NTUEE-ESLab/2018Fall-A_CAR/remote/arduino/sensor_1/sensor_1.ino

#include <NewPing.h>

#define SONAR1 13
#define SONAR2 12
#define SONAR3 11
#define SONAR4 10
#define SONAR5 9
#define SONAR6 8

#define SONAR7 7
#define SONAR8 6
#define SONAR9 5

#define MAX_DISTANCE 800 // maximum distance for sensors
#define NUM_SONAR  8// number of sonar sensors 

NewPing sonar[NUM_SONAR] = { // array of sonar sensor objects
  NewPing(SONAR1, SONAR1, MAX_DISTANCE),
  NewPing(SONAR2, SONAR2, MAX_DISTANCE),
  NewPing(SONAR3, SONAR3, MAX_DISTANCE),
  NewPing(SONAR4, SONAR4, MAX_DISTANCE),
  NewPing(SONAR5, SONAR5, MAX_DISTANCE),
  NewPing(SONAR6, SONAR6, MAX_DISTANCE),
  NewPing(SONAR7, SONAR7, MAX_DISTANCE),
  NewPing(SONAR8, SONAR8, MAX_DISTANCE)
};
 
int distance[NUM_SONAR]; // array stores distances for each
                         // sensor in cm
char out[NUM_SONAR];
void setup() {
  Serial.begin(9600);
}
 
void loop() {
  delay(1);
  updateSonar(); // update the distance array
  
  if (distance[0] != MAX_DISTANCE || distance[1] != MAX_DISTANCE || distance[2] != MAX_DISTANCE || distance[3] != MAX_DISTANCE || distance[4] != MAX_DISTANCE || distance[5] != MAX_DISTANCE || distance[6] != MAX_DISTANCE || distance[7] != MAX_DISTANCE){  
  
  for(int i=0;i<NUM_SONAR;i++){
     if(distance[i] != MAX_DISTANCE){
      out[i] = '1';
     }
     else{
       out[i] = '0';
     }
  }
  // transmit the bool value of each sensor through the serial to Rpi
  for(int i=0;i<NUM_SONAR;i++){
    Serial.print(out[i]);
    }
  Serial.print('\n');
  }
}
 
// takes a new reading from each sensor and updates the
// distance array
void updateSonar() {
  for (int i = 0; i < NUM_SONAR; i++) {
    distance[i] = sonar[i].ping_cm(); // update distance
    // sonar sensors return 0 if no signal received
    // change distance to max value if no attacking signal received
     if (distance[i] == 0 || distance[i] > MAX_DISTANCE){
      distance[i] = MAX_DISTANCE;}
  }
}
